Vitorhrm/Agrosense/AccessPoint/CloudConfig.example.h

#pragma once

// Copie para CloudConfig.local.h. O token deve ser igual ao INGEST_TOKEN da Vercel.
constexpr char CLOUD_READINGS_URL[] = "https://agrosense-lab-vitor-f35a.vercel.app/api/readings";
constexpr char CLOUD_INGEST_TOKEN[] = ""; // Token exclusivo do Access Point; nao use a chave NVIDIA.
