Vitorhrm/Agrosense/Station/SoilCalibrationConfig.h

#pragma once

// Substitua pelas medias medidas no SEU sensor, solo e montagem. -1 = nao medido.
constexpr int SOIL_DRY_REFERENCE = -1; // ADC no solo de referencia seco.
constexpr int SOIL_WET_REFERENCE = -1; // ADC no mesmo solo de referencia saturado.
