Vitorhrm/Agrosense/(commit log)

2026-10-22 docs: update AgroSense setup, architecture and current feature status
2026-11-05 Organiza AgroSense como projeto completo do TCC
    Move o aplicativo web e Android para APP, adiciona os firmwares Transmissor e Receptor, documenta o futuro backend e atualiza o README geral.
2026-11-07 docs: atualiza validacao dos dispositivos e separa painel de teste do aplicativo
2026-11-07 feat: adiciona calibracao de dois pontos para sensor capacitivo de solo
2026-11-10 docs: descreve proposta de descoberta e pareamento LoRa
2026-11-12 Adiciona configuração BLE, índice de solo e proteção de credenciais
2026-11-13 Adiciona catálogo de culturas e coeficientes FAO
2026-11-13 Avalia faixa de solo por área e adiciona verificações de CI
2026-11-13 Exclui dados de sessão do backup do Android
2026-11-13 Corrige conflito com macro HEX do Arduino
    [LoraProvisioning.h]
2026-11-13 Restaura frontend original e remove PIN Bluetooth
